atv98/GATECeR/README.md

# Generic Arduino-based Thermo-Electric Cooler Regulator (GATECeR)

## Overview

Software control of a thermo-electric cooler (TEC), also know as a Peltier device, to maintain a desired temperature.  A temperature sensor provides input to determine a variable power output level to the TEC to maintain the set temperature.  The TEC draws far more power than the Arduino controller board can output and is connected via a MOSFET power controller.  Temperature readings and power levels are displayed on an LCD screen for ease of use.

<p align="center"> 

</p>

## Component List

* Arduino Nano Every
* Adafruit Peltier Thermo-Electric Cooler Module+Heatsink Assembly - 12V 5A (Part 1335)
* SparkFun MOSFET Power Control Kit (Part COM-12959)
* Analog Devices Low Voltage Temperature Sensor (TMP36)
* SparkFun Trimpot 10K Ohm with Knob (Part COM-09806)
* 4D Systems 1.44" Display Module (uLCD-144-G2)
* Generic 12V/5A Power Supply
* Generic 5V/1A Power Supply
* assorted electronics (e.g. breadboard, on/off switch, power connector, wires)

## System Design Schematic

<p align="center"> 

</p>

## System Specification

### Temperature Sensor

The TMP36 sensor is connected to one of the Arduino's analog input, ranging from 0 to 1023 which is converted to temperature values through the following equations:

    raw value = digital output * operating voltage / 1024
    tempC = (raw value - 0.5) * 100
    tempF = (tempC * 9.0 / 5.0) + 32.0
    
To reduce noise in the temperature readings, two methods in both hardware and software were utlilised. Firstly, a 0.1uF capacitor is connected to create a low pass filter, elimintating high frequency noise. Secondly, the raw input is scaled by a carefully callibrated factor and summed with the previous input value, decreasing the overall impact of the added noise but still maintaining accurate temperature determination.

The following equation illustrates this:

    new temp = prev temp + (raw temp - prev temp) * scaling
    
When recreating this, the scaling factor may vary depending on your setup.

### Proportional, Integral, Derivative (PID) Control

Arduino's PWM outputs are controlled using the analogWrite(pinName, value) function, which accepts a value from 0 (0%) to 255 (100%). The TEC's PWM output is set by a Proportional-Integral-Derivative (PID) control loop using smoothed temperature feedback from the TMP36.

The PID control equation is as follows:

    error = Setpoint - Sensor Measurement
    ControlOutput = Kp * (error) + Ki * (cumulative error) + Kd * (error rate of change)

and is realized by the computePID(sensor reading) function. Its principal parameters Kp, Ki, and Kd are manually tuned by trial and error according to the general guideline:

    1) Increase Kp until the response reaches an acceptable steady state neighborhood of the setpoint, either above or below it.
    2) Increase Ki until the response eliminates its steady state error, but before the output begins to steadily oscillate.
    3) Increase Kd if desired; it can sometimes mitigate over/undershoot severity. Be careful! It is susceptible to noisy sensors.

Using this process, the TEC PID loop was tuned to the following gains: Kp = -100, Ki = -0.001, Kd = -0.01. If you're recreating this project, your mileage with these gains may vary depending on your setup and power supply.

### Thermo-electric Cooler

The Adafruit Thermo-electric cooler consists of a peltier module connected to one of the Arduino's PWM enabled digital pins through a power MOSFET powering the module with 12V and up to 5A. The amount of cooling is controlled by the PID algorithm described earlier in order to maintain desired temperature. The heat sink module is also powered by the same 12V/5A power supply.

### uLCD Display

The uLCD display runs off a 5V supply and utilizes the only two RX and TX pins of the Arduino Nano Every board as well as any digital pin for the reset pin. It is used to display the desired temperature, current temperature as well as the PWM value currently set by the PID controller.

If you are recreating this project, the 4DGL-uLCD-SE zip folder found in this repository needs to be uploaded to the Arduino compiler that you are using. This can be done from the IDE menu following this specified path:

    sketch\ include library\ add .ZIP library
    
## Pin Connections
### Thermo-electric Cooler (TEC) Assembly



TEC Connectors | MOSFET Board | 12V Supply
:---:|:---:|:---:|
Cooler + | + |
Cooler - | - |
Fan + | | +
Fan - | | -

### MOSFET Power Control Kit



MOSFET pin | Arduino pin | TEC | 12V Supply
:---:|:---:|:---:|:---:|
JP2-1 RAW ||| +
JP2-2 GND | GND || -
JP2-3 Control	| D9 ||  
JP1-1 || Cooler + |
JP1-2 || Cooler - |

### Analog Devices Low Voltage Temperature Sensor (TMP36)


TMP36 pin| Arduino pin
:---:|:---:|
 GND |  GND
 Vs | Vout (3.3V)
 Vout | A0

### 4D Systems 1.44" Display Module (uLCD-144-G2)


uLCD | Arduino pin | 5V Supply
:---:|:---:|:---:|
5V || +
GND |  GND | -
TX |  RX |
RX |  TX |
RES| D3 |

## Challenges Overcome

If you're recreating this project, make sure to look out for these potential problems that we had to solve:

Regarding the sensing circuit of the system, eventhough a capacitor was connected to form a low pass filter, the cutoff frequency was not sufficient to eliminate some of the high frequency noise. This was due to a lack of capacitor values availible from our remote locations. Inititally, we took a running average of 5 readings spaced by 100ms, which didn't seem to eliminate the noise to a sufficient level, so the scaling method described previously was instead implemented.

The TMP36 is a finicky sensor. It can run off of 5 or 3.3V, but we were only able to get sensor values calibrated correctly at 5V, though 3.3 is theoretically less noisy. Additionally, if you wire V+ and GND backwards on the sensor, it will fry pretty quickly. Pay attention to orientation.

Compared to an Arduino, the TEC assembly uses a lot of current. That current is sufficient to melt smaller jumper wires, breakout boards, and breadboards. Keeping wires shorts help, as does using larger gage wires. 22 gauge solid core wires were used for the power connections to the TEC. If you use the SparkFun MOSFET Power Control Kit as in this project, keep a close eye on it. The included MOSFET is rated for 60A, however, the traces on the breakout board are only rated for 3A!

Do not believe everything you read on the Internet. There is a pinout diagram for the Arduino Nano Every circulating that shows an included DAC which would have been useful for this project. However, that pinout appears created based on a preliminary datasheeet for the ATmega4809 microprocessor that included an external DAC connection. The final datasheet shows none, and the Arduino Nano Every does not include such.

Do not believe everything you read on the Internet, part II. 4D Systems provides several sample programs to test the uLCD-144-G2. They include setting the reset pin high to reset and low to unReset. At least in this project, the opposite was true. When something that otherwise works refuses to work after hours of testing, start trying other things safely. You might just find your bits flipped too.

## Future Improvements

One potential improvement that could be implemented is to power the entire system using a single 12V power supply, which can be done through a number of voltage regulator ICs allowing the Arduino Nano board and the uLCD display safely receiving the 5V they need with the TEC getting the 12V it will use.

Another improvement could be to refine the use of the delay() function calls used in the software that forces the entire program to halt for periods of time. This could be done using interrupts or through Arduino's RTOS capibilities whereby one thread is used for temperature aquistion, one for updating the uLCD display and a third for controlling the TEC.

## Video Links

### Presentation:
BlueJeans Presentation Recording: https://bluejeans.com/s/D8p4b

[Alternate Link] Youtube Presentation: https://youtu.be/ikx0H42VAZE

### Demonstration:
YouTube Demonstration: https://youtu.be/SU1SXLJOUXU

[Bonus - 22 sec] YouTube Supercooled Water Demo: https://youtu.be/pr9UDZsbhZ8 

[Bonus - 15 sec] YouTube Slo-mo water-to-ice Clip: https://youtu.be/LM5lOf-T3tI 

## Data Sheet & Product Pages
### Arduino Nano Every
https://www.sparkfun.com/products/15590
### Adafruit Peltier Thermo-Electric Cooler Assembly
https://www.adafruit.com/product/1335
### SparkFun MOSFET Power Control Kit
https://cdn.sparkfun.com/datasheets/Components/General/RFP30N06LE.pdf

https://www.sparkfun.com/products/12959
### Analog Devices Low Voltage Temperature Sensor (TMP36)
http://www.analog.com/media/en/technical-documentation/data-sheets/TMP35_36_37.pdf

https://www.sparkfun.com/products/10988
### SparkFun Trimpot 10K Ohm with Knob
http://www.sparkfun.com/datasheets/Components/General/TSR-3386.pdf

https://www.sparkfun.com/products/9806
### 4D Systems 1.44" Display Module (uLCD-144-G2)
https://4dsystems.com.au/mwdownloads/download/link/id/261/

https://4dsystems.com.au/ulcd-144-g2

https://www.sparkfun.com/products/11377

## Authors

* Ryan Khan - EE
* David Thompson - EE
* An Vo - EE
