atv98/GATECeR/GATECeR_Schematic_Picture.png

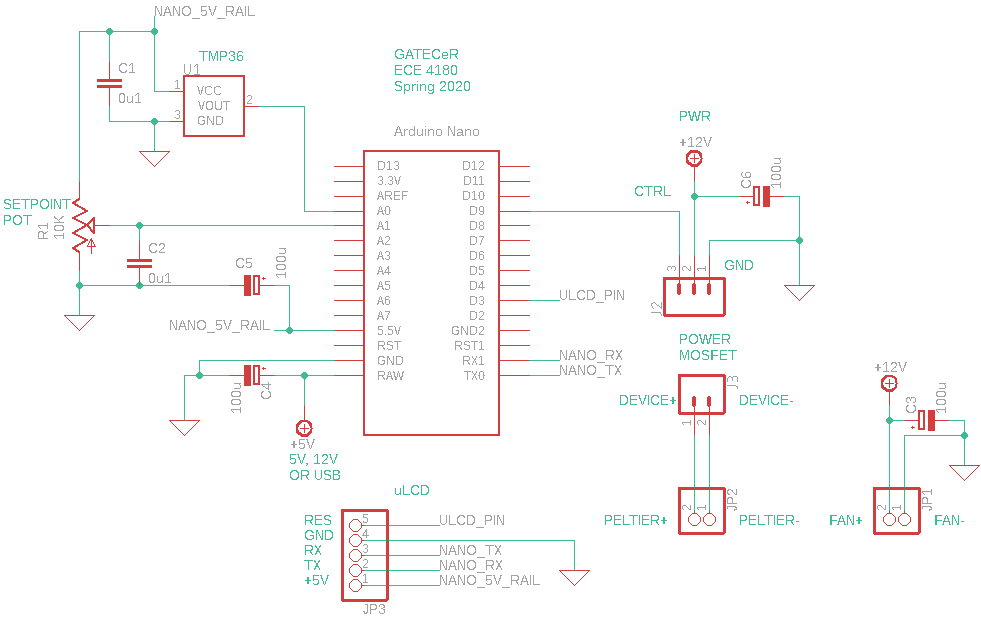
GATECeR_Schematic_Picture.png
