atv98/GATECeR/(commit log)

2020-04-23 Calibration code for TMP36
    Run this program to see if your TMP36 is reading back correctly. TMP36 Vout goes to Nano A0. 5V supply. I have a 100 uF cap across ardunio 5V and GND and a 1 nf (I think? just grabbed an unlabeled cap from my miscellaneous parts) cap across TMP36 Vout and GND.
2020-04-25 Add files via upload
    Adds PWM control of TEC through SparkFun MOSFET power control board. Worked, although a little slow, with 5V 2A power supply (may want to change the offset variable to "2.0"). Worked fairly well with 12V 5A supply at 12degC.
2020-04-27 First Pass at PID Control
    Tune Kp, Ki, Kd to change how the TEC responds. Update rate is set by delay() time in loop().
2020-04-28 Add files via upload
    Sample test code to confirm uLCD on Arduino Nano Every (requires installing uLCD library first)
2020-04-28 Add files via upload
    Changed conversion from sensor reading-to-voltage to a single multiplication, increased number of sensor readings to average per loop.
2020-04-28 Partially tuned gains and variable setpoint
    Decreased loop time to 100 ms for faster response. Variable setpoint through a potentiometer connected to A IN 1. Currently maps pot value to -1 ->15 C, feel free to change. Kp = -100 and Ki = -0.001 to start with.
2020-04-28 New smoothing method
    Using An's sensor smoothing code with PID.
2020-04-29 Additional schematics with pin-outs
2020-04-29 Schematic Picture
2020-04-29 test PID text
    figuring out how to edit the readme
2020-04-29 PID description
2020-04-29 updated PID description
2020-04-29 Added schematics, cleaned up code
2020-04-29 uLCD library files for Arduino
